johnhmacleod/waterworld/README.md

# waterworld

This is the readme file for the Waterworld Demo

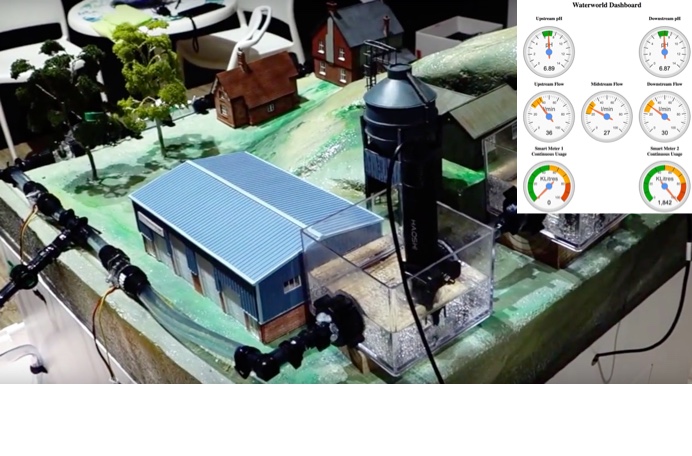
[picture p1: 2016-05-30_12-18-35.jpg]


Here's the URL for the video we made of the model in action

https://www.youtube.com/watch?v=EnL_uP_GrjQ (7 minutes)

This is the full "Road to OzWater" video of the making of the Waterworld model

https://www.youtube.com/watch?v=yLIvjveedbY (15 minutes)
