johnhmacleod/waterworld/nodered/README.md

This folder contains Node Red flows used for the dashboard & to raise the Maximo work orders.

If the Twilio nodes are configured correctly, it will also send an SMS to a nominated mobile number when an alert condition is detected and with the Maxmio work order number when it is raised.

Dashboard
