johnhmacleod/waterworld/hardware/orderhardware.md

Processor
http://www.aliexpress.com/item/new-Wireless-module-CH340-NodeMcu-V3-Lua-WIFI-Internet-of-Things-development-board-based-ESP8266/32520574539.html

Flow Sensor (I used these...)
http://www.aliexpress.com/item/Hight-Quality-Transparent-Water-Flow-Control-Switch-Sensor-Flowmeter-Counter-1-30L-min-1-75Mpa/32528481052.html
...but these are cheaper & may be better - they use a different mechanism that may be less sensitive to air bubbles!
http://www.aliexpress.com/item/G1-2-Water-Flow-Sensor-Fluid-Flowmeter-Switch-Counter-1-30L-min-Meter-E2shopping/32617842149.html

pH Meter
http://www.dfrobot.com/index.php?product_id=1110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

These are a bit more expensive than others from the same vendor but are fine with being continually submersed.
