johnhmacleod/waterworld/(commit log)

2016-05-29 Add the flow code
2016-05-30 Add node red flows
